Fortuz/mecanumbot/README.md

# Mecanumbot Project - Onboard Jetson codes

Mecanumbot is a mecanum-wheel member of the TurtleBot3 family, and the experimental robot platform for HRI and attention-guidance research.
This repository holds the ROS 2 Humble packages that run **on the robot itself**, on an NVIDIA Jetson Orin Nano (Ubuntu 22.04): the OpenCR hardware interface, launch orchestration, robot description and assets, joystick control, the web GUI, LEDs, camera capture, audio, and the map analysis behind the Deep3R seeking system.

## Built on TurtleBot3

Mecanumbot started from the original TurtleBot3 packages, but it uses a mecanum-wheel drive instead of a differential drive, and it adds motors that speak different protocols. That meant changing the original architecture, so a large part of the codebase has been modified. The aim is to keep the same functionality as the original TurtleBot3 repositories.

The setup steps are mostly the same as TurtleBot3's, so the TurtleBot3 e-Manual is still the main reference for documentation and background. The steps that matter for Mecanumbot are written out below.

- 📘 [TurtleBot3 e-Manual](https://emanual.robotis.com/docs/en/platform/turtlebot3/overview/#overview)
- 🐢 [turtlebot3, humble branch](https://github.com/ROBOTIS-GIT/turtlebot3/tree/humble)
- ✉️ [turtlebot3_msgs, humble branch](https://github.com/ROBOTIS-GIT/turtlebot3_msgs/tree/humble)

## Project Repositories

- [mecanumbot](https://github.com/Fortuz/mecanumbot) **(this repository)**: ROS 2 packages that run on the NVIDIA Jetson Orin Nano on the robot
- [mecanumbot_msgs](https://github.com/Fortuz/mecanumbot_msgs): every custom `.msg`/`.srv`, a build dependency of most packages here
- [mecanumbot_sensorprocess_smart](https://github.com/hubaycsenge/mecanumbot_sensorprocess_smart): LiDAR and camera people detection and their fusion
- [mecanumbot_behaviours](https://github.com/hubaycsenge/mecanumbot_behaviours): the `py_trees_ros` behaviour trees
- [mecanumbot_remote](https://github.com/Fortuz/mecanumbot_remote): ROS 2 packages for an external computer connected to the robot (keyboard teleop, LED GUI, and the `mecanumbot_sim` simulator)
- [mecanumbot_server](https://github.com/hubaycsenge/mecanumbot_server): ROS 2 packages that talk to the off-board compute server (`mecanumbot_deep3r`)
- [mecanumbot_microcontrollers](https://github.com/Fortuz/mecanumbot_microcontrollers): the microcontroller code
- [mecanumbot_python](https://github.com/fegyobeno/mecanumbot_python.git): native Python scripts for driving the motors, kept on the robot in `~/Sandbox`

## Packages in this repository

There are twelve packages, including the `mecanumbot` metapackage. All of them belong to the onboard Jetson stack, and `mecanumbot_monitor` also works on a development machine.

- **`mecanumbot`**: Dependency aggregation only. No nodes, no launch files: installing it pulls in the runtime packages.
- **`mecanumbot_core`**: The only code that talks to the OpenCR board. `mecanumbot_io_node` owns the serial link (CRC8-CCITT framing) and the mecanum kinematics, turning `cmd_vel` into four wheel commands; `mecanumbot_sensorproc_node` turns board telemetry into `odom`, `imu`, `joint_states`, battery state, `has_object` and the `odom → base_footprint` transform, plus `orin_battery_state` from the INA219 when running on a Jetson; `mecanumbot_battery_alert` raises a visible low-battery alarm; `mecanumbot_scan_grid_node` republishes the LD08 scan on a fixed 200-sector grid as `/mecanumbot/scan_grid`, which is what slam_toolbox reads.
- **`mecanumbot_bringup`**: Launch orchestration. No node logic of its own — it starts nodes from the other packages and picks map / Nav2 params from the current Wi-Fi SSID. Holds `launch_mecanumbot_base.launch.py` (full onboard stack), `nav2.launch.py` (the study Nav2 stack, included by the base launch under `use_nav2` and restartable on its own), `launch_external.launch.py` (operator PC), and the camera, state-publisher, mapping, SLAM and RViz launches. Simulated runs are not started from here: `sim.launch.py` is in `mecanumbot_sim`, in `mecanumbot_remote`, and does not need this package.
- **`mecanumbot_description`**: Robot assets, no nodes: URDF/xacro and meshes, maps, Nav2/SLAM/Cartographer parameter sets (including the T1 exploration and T2 seek Nav2 sets), the Nav2 behaviour-tree XMLs, RViz layouts, the joystick profile YAMLs, the udev rules for `/dev/opencr`, `/dev/ld08_lidar` and `/dev/arduino_nano`, and the systemd autostart unit.
- **`mecanumbot_joy`**: The robot's joystick node and the only `/joy` consumer. Applies a YAML mapping profile (`mecanumbot_description/config/joystick/`) to publish `/cmd_vel`, `/cmd_accessory_pos` and LED service calls. Layout decoding, profile validation and the action vocabulary live in rclpy-free modules, so they are unit-tested without a ROS graph. Replaces the old operator-PC teleop and the retired `mecanumbot_gui` controller stack.
- **`mecanumbot_web`**: The robot-hosted web GUI (Flask inside an rclpy node) at `http://<robot>:8080`, started by the base launch and disabled with `use_web:=false`. Three pages: `/joystick` edits and reloads the joystick profile with a live `/joy` readout, `/diagnostics` shows Nav2 stack state (with a restart), LED state, commanded-vs-measured movement and measured publish rates against nominal, `/behaviour` picks one of the behaviour trees (leading, ostensive, seek, fetch, autoslam, demo), edits the constants it loads and starts/stops it. No login, no database.
- **`mecanumbot_led`**: `set_led_status` / `get_led_status` services, forwarded over serial to the Arduino Nano LED controller at `/dev/arduino_nano`.
- **No camera publisher.** `mecanumbot_camera_stream` -- raw, JPEG and H.264 publishers for the webcam -- was removed on 2026-10-09. Nothing included it any more: the base launch had stopped, `perception.launch.py` had stopped, and the two things that want frames each open `/dev/video0` themselves (`mecanumbot_deep3r` with `camera_source:=direct`, `mecanumbot_sensorprocess_smart`'s detectors likewise). A device opens once, so a publisher nobody read was a publisher that could only take the camera away from whoever did. What a topic-based consumer needs instead is below.
- **`mecanumbot_cam_optim`**: A C++ capture path, built on `rclcpp`, `cv_bridge` and `image_transport`: `camera_stream_node` publishes JPEG on `/camera/image_raw/compressed` from `device` (default `/dev/video0`), trying a `libcamerasrc` pipeline first and warning before it falls back to V4L2 -- the normal path on this robot, which has no CSI camera. It has no launch file, so `ros2 run`. **This is now the only image publisher in the workspace**, and the only way to feed anything set to `camera_source:=topic`. No README; package manifest is still a TODO stub.
- **`mecanumbot_audio`**: Publishes microphone blocks as `mecanumbot_msgs/AudioData`, with device auto-detection and reopen-on-failure. No README.
- **`mecanumbot_custom_nav2`**: Map analysis for the Deep3R seeking system, and no motion. Libraries: an RRT frontier detector over slam_toolbox's occupancy grid, the occupancy model, the frontier scoring, and the T1 exit criteria (which include the server's reconstruction verdict). The pass that drives on the strength of them is `mecanumbot_autoslam`, in `mecanumbot_behaviours`; sending the robot to a frontier is a behaviour, so it lives there with the launch files that start it. It replaces no part of Nav2: the exploration tuning is a parameter file in `mecanumbot_description`. `mecanumbot_map_agreement_node` runs in **both** phases and is the robot's end of the 2D/3D comparison: it turns the server's verdict into a Nav2 keepout mask (the lidar is one horizontal plane, so a table top or a low step is "free" in the 2D map and lethal in the cloud), a revisit list and RViz markers. It only ever *adds* obstacles.
- **`mecanumbot_monitor`**: Test and evaluation utilities: `wheel_monitor` and `accessory_monitor` generate repeatable command patterns for drivetrain and servo testing; `rosbag_stepper` chunks bag playback; `metric_eval` logs ground truth against detections to CSV.

Every package except `mecanumbot`, `mecanumbot_audio` and `mecanumbot_cam_optim`
has its own README with the full publisher / subscriber / parameter tables — read
the relevant one before changing a node interface.

## Hardware

The full component list — every board, motor, sensor and 3D-printed part, with where to buy it and a price — is in [docs/COMPONENTS.md](docs/COMPONENTS.md).

## Onboard computer

The whole onboard stack runs on an **NVIDIA Jetson Orin Nano** (JetPack 6, Ubuntu 22.04, ROS2 Humble). Earlier revisions of the robot used a Raspberry Pi; the packages in this repository are now developed and tested on the Orin Nano.

What the platform change means in practice:

| Area | On the Jetson Orin Nano |
| --- | --- |
| OS / ROS | JetPack 6 (Ubuntu 22.04) + ROS2 Humble, `aarch64`. |
| Camera | A USB (UVC) webcam on `/dev/video0`, opened with V4L2 by whichever node needs it -- there is no camera publisher and no CSI camera. The mode is a *request*: `cap.set` on a webcam that cannot do 1280x720 picks something else and reports success, so the node that opened it reads the mode back and logs what it got. |
| H.264 encoding | Nothing encodes H.264 any more; it went with `mecanumbot_camera_stream`. Frames are JPEG, encoded once by the node that read them. |
| Onboard power rail  | `mecanumbot_sensorproc_node` reads an INA219 over I2C and publishes `orin_battery_state`. This publisher only exists when the device tree reports a Jetson. |
| GPIO | The `wiringpi` debug toggle from the Pi build is disabled; `wiringpi` is not installed and is not a dependency. |
| Serial devices | OpenCR, LD08 lidar and the LED Arduino Nano are still USB serial and are addressed through the udev rules in `mecanumbot_description/udev/`. |

Nodes detect the board at runtime by reading `/proc/device-tree/model`, so the same source tree still starts up on a non-Jetson machine — the Jetson-only publishers are simply skipped.

### Jetson specific setup

```
$ sudo usermod -aG dialout,i2c $USER   # serial + INA219 access, re-login afterwards
$ sudo nvpmodel -q                     # list available power modes
$ sudo nvpmodel -m 0                   # highest power mode (mode numbers differ per Orin Nano variant)
$ sudo jetson_clocks                   # lock clocks to max for consistent latency
$ pip install adafruit-blinka adafruit-circuitpython-ina219
```

`adafruit-blinka` provides the `board` and `busio` modules that `mecanumbot_sensorproc_node` imports on the Jetson.

Check that the board is what the nodes expect:

```
$ cat /proc/device-tree/model     # -> NVIDIA Jetson Orin Nano ...
$ sudo i2cdetect -y -r 7          # INA219 should show up (bus number can differ)
```

<p align="center">
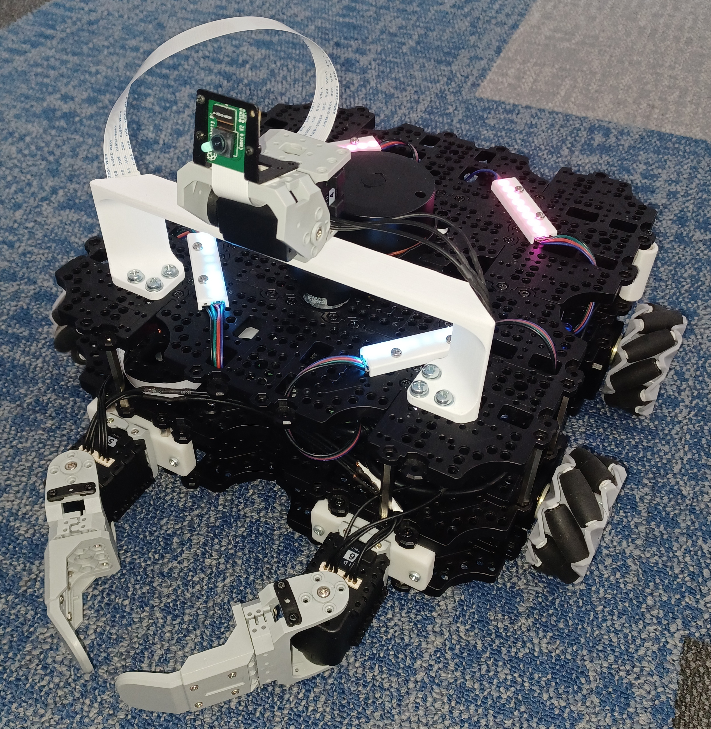
[picture p1: docs/images/mecanumbot.jpg]
Mecanumbot
  
</p>

<p align="center">
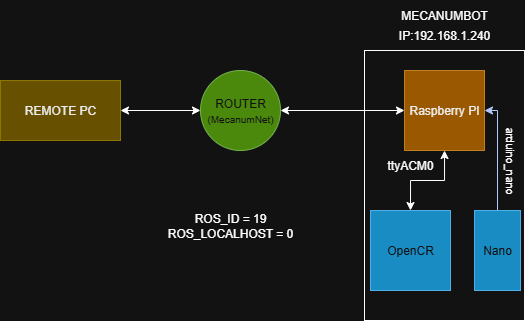
[picture p2: docs/images/turtlebot_architecture.drawio.png]
Architecture
  
</p>

## Install

Run this on the Jetson Orin Nano (the `ubuntu` user and the `192.168.1.240` address below are the ones flashed on the current robot — adjust if yours differ).

```
$ ssh ubuntu@192.168.1.240
$ mkdir -p ~/mecanumbot_ws/src && cd ~/mecanumbot_ws/src
$ git clone https://github.com/Fortuz/mecanumbot.git
$ cd ~/mecanumbot_ws/
$ echo 'source /opt/ros/humble/setup.bash' >> ~/.bashrc
$ source ~/.bashrc
$ colcon build --symlink-install --parallel-workers 2
$ echo 'source ~/mecanumbot_ws/install/setup.bash' >> ~/.bashrc
$ source ~/.bashrc
$ echo 'export OPENCR_PORT=/dev/ttyACM0' >> ~/.bashrc
$ echo 'export OPENCR_MODEL=mecanumbot' >> ~/.bashrc
$ echo 'export ROS_DOMAIN_ID=19' >> ~/.bashrc
$ echo 'export LDS_MODEL=LDS-02' >> ~/.bashrc
$ echo 'export TURTLEBOT3_MODEL=mecanumbot' >> ~/.bashrc
$ echo 'export ROS_LOCALHOST_ONLY=0' >> ~/.bashrc
$ echo "export RMW_IMPLEMENTATION=rmw_cyclonedds_cpp " >> ~/.bashrc
$ echo "alias start_robot='ros2 launch mecanumbot_bringup launch_mecanumbot_base.launch.py'" >> ~/.bashrc
$ source ~/.bashrc

```

The Orin Nano has enough RAM to build with more than one worker, but a full workspace build can still exhaust memory. If `colcon` gets OOM-killed, drop back to `--parallel-workers 1` or add swap.

Also install the udev rules so `/dev/opencr`, `/dev/ld08_lidar` and `/dev/arduino_nano` exist:

```
$ sudo cp ~/mecanumbot_ws/src/mecanumbot/mecanumbot_description/udev/*.rules /etc/udev/rules.d/
$ sudo udevadm control --reload-rules && sudo udevadm trigger
```

### Autostart on boot

The startup script and the systemd unit are kept in the repository under `mecanumbot_description/services/`, so they do not have to be written by hand:

```bash
$ chmod +x ~/mecanumbot_ws/src/mecanumbot/mecanumbot_description/services/autostart.sh
$ sudo cp ~/mecanumbot_ws/src/mecanumbot/mecanumbot_description/services/ros2.service /etc/systemd/system/ros2.service
```

Both files reference the `ubuntu` user and `/home/ubuntu/mecanumbot_ws`. If the Jetson was flashed with a different username, edit the `User=` line in `ros2.service` and the source paths in `autostart.sh` before installing.

Reload systemd and enable the service:

```bash
$ sudo systemctl daemon-reload
$ sudo systemctl enable ros2.service
```

Check the service logs:

```bash
$ journalctl -u ros2.service -f
```

## Bringup

```
$ ssh ubuntu@192.168.1.240
$ start_robot
```

The base launch already starts `mecanumbot_led_service`; starting a second one by hand would open `/dev/arduino_nano` twice.

## Connect new PC to robot

[Remote PC]

Install Ubuntu 22.04 OP system [Ubuntu 22.04](https://emanual.robotis.com/docs/en/platform/turtlebot3/overview/)

Install ROS2 Humble [ROS2 Humble install tutorial](https://emanual.robotis.com/docs/en/platform/turtlebot3/overview/)

Set static IP for computer on MecanumNet (192.168.1.XXX, XXX between 2 and 255)

<p align="center">
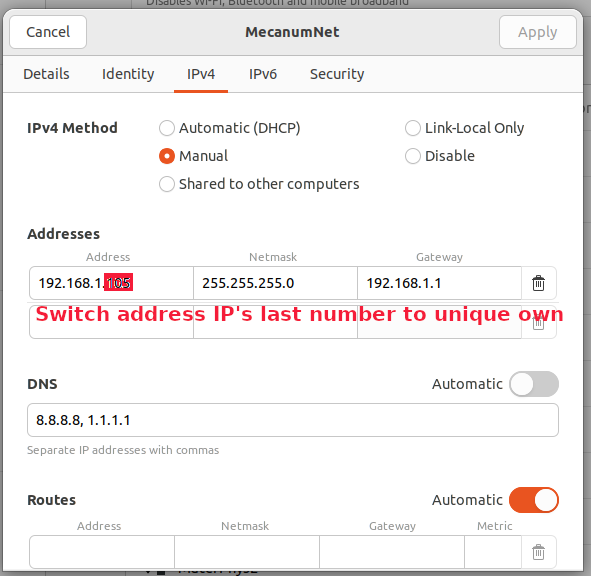
[picture p3: docs/images/MecanumNet_settings.png]
  
</p>

```
$ sudo apt update
$ sudo apt install ros-humble-navigation2 ros-humble-nav2-bringup ros-humble-tf-transformations ros-humble-py-trees ros-humble-py-trees-ros ros-humble--rmw-cyclonedds-cpp
$ pip install torch
$ mkdir mecanumbot_directories #makes stuff prettier to have all in one space
$ cd mecanumbot_directories
$ git clone https://github.com/VisualComputingInstitute/DR-SPAAM-Detector.git  # leg detector nn
$ cd DR-SPAAM-DEetector/dr_spaam
$ python setup.py install
$ cd ../../
$ mkdir mecanumbot_ws &c cd mecanumbot_ws
$ mkdir src && cd src
$ git clone https://github.com/Fortuz/mecanumbot
$ git clone https://github.com/Fortuz/mecanumbot_remote
$ git clone https://github.com/Fortuz/mecanumbot_msgs
$ git clone https://github.com/hubaycsenge/mecanumbot_behaviours
$ git clone https://github.com/hubaycsenge/mecanumbot_sensorprocess_smart
$ cd ..
$ colcon build --symlink-install
$ echo 'export RMW_IMPLEMENTATION=rmw_cyclonedds_cpp' >> ~/.bashrc
$ echo '~/mecanumbot_directories/mecanumbot_ws/install/setup.bash' >> ~/.bashrc
$ echo 'export ROS_DOMAIN_ID=19' >> ~/.bashrc
$ source ~/.bashrc
```

[ Mecanumbot ]

```
$ sudo nano /etc/chrony/chrony.conf
$ server 192.168.1.XXX minpoll 0 maxpoll 2 iburst #XXX is your PC's unique IP
$ sudo systemctl restart chrony
```

## TESTS

### LED control

Send a message to get back the actual status of the leds

```
$ ros2 service call /mecanumbot/get_led_status mecanumbot_msgs/srv/GetLedStatus "{}"
```

Send a message to set the status of the leds

```
$ ros2 service call /mecanumbot/set_led_status mecanumbot_msgs/srv/SetLedStatus "{
  fl_mode: 1,
  fl_color: 3,
  fr_mode: 1,
  fr_color: 3,
  br_mode: 1,
  br_color: 3,
  bl_mode: 1,
  bl_color: 4
}"
```

PC

```
$ echo "export RMW_IMPLEMENTATION=rmw_cyclonedds_cpp " >> ~/.bashrc
$ cd ~/dev_ws
$ source_ros
$ source_ws
$ ros2 run mecanumbot_teleop mecanumbot_keyboard
$ ros2 launch mecanumbot_ledgui mecanumbot_ledgui.launch.py
```

Parameters: `<br>`
wheel diameter: 65 mm `<br>`
wheel radius: 32.5 mm `<br>`
wheel thickness: 30 mm `<br>`
wheel separation x: 129 mm `<br>`
wheel separation y: 300 mm `<br>`
