Fortuz/mecanumbot/mecanumbot_web/README.md

# mecanumbot_web

The robot-hosted web GUI. A normal rclpy node that also serves Flask, reachable
at `http://<robot>:8080` once the onboard stack is up.

**Off the lab WiFi, use `robot web`.** The node binds `0.0.0.0:8080` and starts
with the base launch — `use_web` defaults true, and nothing in the Deep3R / T1
path turns it off — but the robot↔cluster link in
`mecanumbot_directories/RoboCamStreamProcessing/link/` forwards only two ports,
22 and 5555. nipg1 has no route to the robot's LAN, so from there the page does
not answer, which looks exactly like the node having failed to start. `robot
web` forwards it over the control tunnel that already exists and prints the URL;
`MECANUMBOT_SSH_HOST=mecanumbot-jump robot web` does the same from a laptop.
Deliberately on demand and bound to your own loopback: this GUI has no login and
can drive the robot. See that directory's README.

It replaces a Flask app that ran in a Docker container **on the operator PC**,
paired with two ROS packages on the robot, sharing a SQLite schema that existed
in two copies — one per machine. That arrangement is what produced the "host
settings vs robot settings" split throughout the old UI: a
`destination: host | robot | both` parameter on six API routes, a
`from_robot_db` flag on `ApplyMapping`, and two side-by-side host/robot mapping
panels. None of it described anything about the robot; it only arbitrated
between two files. With the GUI on the robot there is one copy — the YAML in
the packages that own it — so the distinction has nothing left to describe.

There is no login and no database.

## Pages

| Path | Function |
| --- | --- |
| `/joystick` | Edit and reload `mecanumbot_joy`'s profile, with a live input readout. |
| `/diagnostics` | Whether the navigation stack is up, with a restart; what the LEDs are showing, how the robot is moving, and the measured publish rate of every important topic against nominal. |
| `/teleop` | Drive the robot, move the neck and grabbers, and set the LEDs. |
| `/behaviour` | Choose a behaviour tree, edit the constants it will load, and run it. |
| `/maps` | Choose the map folder nav2 loads, and load it. |

`/` redirects to `/diagnostics`.

### Alert lines

Every page polls `/api/alerts` every 2 s and shows each hardware fault as one thin
line under the tabs, which stays in view when the page is scrolled. The faults come
from `mecanumbot_core`'s `mecanumbot_battery_alert`, on `hardware_alerts`, so the page
and the node cannot disagree about thresholds or timing, and nothing here has to
deserialise the 100 Hz `opencr_state`.

| Line | Means |
| --- | --- |
| Yellow | Motors not responding: the OpenCR cannot read the Dynamixel bus. |
| Red | OpenCR not responding, or a battery is low (the LEDs blink red for that too). |
| Grey | Faults unknown: the monitoring node is not reporting, or the page lost the robot. |

The grey line exists because no line at all has to mean a healthy robot.

### Joystick

Bindings are rendered as the ten fixed vocabulary rows, each with a dropdown
populated from the controls *that profile declares* — so a binding naming a
control the pad does not have cannot be expressed, rather than merely being
rejected on save. Validation is `mecanumbot_joy.profile.validate_document`, the
same function the node runs, so the GUI cannot save something the robot would
refuse to load.

The live readout polls `/joy` at 5 Hz and shows which axis or button index
moved. That is the fastest way to build a profile for a pad nobody has mapped
before, and it is what the old GUI's static controller PNG never provided.

### Diagnostics

Answers "is each node keeping up?". Nothing in the workspace measured this
before — the old GUI had presence/absence watchdogs that could tell you a topic
had gone silent, but not that it had quietly dropped from 100 Hz to 12 Hz.

Subscriptions are created with `raw=True`, so payloads are never deserialised
and monitoring a 100 Hz `OpenCRState` costs almost nothing on the Orin. Rates
come from a sliding window over *receipt* times: several monitored topics carry
no header at all, and the question being asked is whether the pipeline is
delivering to a subscriber.

| Status | Meaning |
| --- | --- |
| `OK` | Within tolerance of nominal. |
| `SLOW` | Running but below tolerance — usually CPU contention or a blocked callback. |
| `FAST` | Above tolerance. Informational; usually means the nominal figure is stale. |
| `IDLE` | Silent, but silence is this topic's resting state and it is still wired up. |
| `DEAD` | Nothing on the graph holds the topic up, or nothing received recently enough to measure. |

The nominal table is `config/diagnostics_topics.yaml`; every rate in it is read
from the node that publishes it, with the source noted per entry. Topics with
`nominal_hz: 0` are event-driven and judged on staleness alone, so an idle
`/cmd_vel` never reads SLOW.

#### Navigation stack

The first panel answers "is nav2 up, and if not, bring it back". The state is
one word: `ACTIVE`, `INACTIVE` (every server registered, but a lifecycle
manager reports them inactive — the shape of a bringup that aborted, which
presence alone reads as healthy), `NO ANSWER`, `PARTIAL`, `DOWN`, or `T1` when
an exploration pass is running its own nav2. Presence comes from the graph and
activity from each manager's `is_active` service, asked from the page's own
poll every 3 s with a 1 s timeout.

**Restart is a relaunch, not a lifecycle reset.** A T1 pass's preflight
signals the composed `nav2_container` away rather than deactivating it, so
after T1 there is nothing left for `manage_nodes` RESET to reset. A restart
(`nav_stack.py`) therefore:

1. stops the stack wherever it came from — the one this page launched
   last time via its process group, and any other local process whose command
   line carries `__node:=<a study nav2 node>` (the base launch's container, the
   keepout servers), by pid with SIGINT, then SIGTERM, then SIGKILL. Matched on
   that whole argument only, so the base `ros2 launch` whose arguments merely
   name nav2 is never touched, and **not** excluding this node's process group:
   the base launch started this node and nav2 together, so they share one;
2. waits for every study nav2 name to leave the **graph**. A new
   `lifecycle_manager_navigation` configures servers by name, and an old one
   still answering aborts the new bringup. A stack on another machine
   (`launch_external` can start one) has no local process to signal, stays on
   the graph, and the restart fails naming it rather than launching over it;
3. runs `ros2 launch mecanumbot_bringup nav2.launch.py` as a child, whose
   console the panel shows. The launch file re-reads the SSID, so a restart
   after moving rooms loads the other room's map, unless the maps page has
   pinned one.

**Refused while** a tree runs from the behaviour page, a tree is on the graph
from a terminal, or a T1 pass is up (its nav2 uses the same node names, so a
restart would kill it). Restarting under a tree drops its goals mid-trial.
AMCL comes back at its initial pose, so the pose estimate has to be set again;
the confirmation dialog says so.

A stack relaunched from here is a child in its own session, so a Ctrl-C of the
base launch does not reach it; `web_node`'s shutdown stops it, after any tree.
A stack the base launch started is that launch's, and is left alone at shutdown.
`mecanumbot_bringup` is not declared as a dependency, because bringup depends
on this package; the launch file is only found at runtime.

On a machine with no robot attached the costmaps wait for TF indefinitely
during activation and ignore SIGINT and SIGTERM while they do, so there a
restart always escalates to SIGKILL. Expected; on the robot they exit on
SIGINT.

#### Idle is not dead

Several topics are *supposed* to be silent most of the time, and grading those
red would train the operator to ignore the colour that means something is
broken. `idle_when_silent: true` in the table marks them, and `presence` says
which end of the topic proves it is still wired up:

| Topic | Silent because | Alive because |
| --- | --- | --- |
| `/cmd_vel`, `/cmd_accessory_pos` | nothing is driving the robot | the io_node is still **subscribed** — nothing publishes these at rest, so the listener is the only evidence the link is intact |
| `people_fusion`, `subject_pose` | nobody is in view (`mecanumbot_locate_detections` only publishes a non-empty array; `subject_pose` publishes nothing until a subject is first seen) | the detector is **publishing** it at all |

So `DEAD` on `/cmd_vel` means a command would go nowhere, and `DEAD` on
`people_fusion` means the detector is down — both real faults, neither of them
"the robot is standing still" or "the room is empty". The table shows both
endpoint counts, dimming whichever one is not deciding.

Three traps the implementation handles: monitor subscriptions are BEST_EFFORT
(`scan` and the compressed camera topics are published that way, and a RELIABLE
subscription silently never matches one, so a healthy topic would read DEAD);
discovery re-runs on a timer, because this node starts alongside everything it
monitors and a one-shot lookup would miss all of it; and the subscriber count
discounts this node's own monitoring subscription — it subscribes to everything
in the table, so a raw `count_subscribers` would never be zero and a
subscriber-judged topic could never read DEAD.

#### Robot state: LEDs and movement

Rates answer "is every node keeping up?", which is not the same question as
"what is the robot doing". Two panels above the topic table answer the second
one, from the same 1 Hz poll — `/api/diagnostics` carries `led` and `motion`
alongside `topics`, so the page makes no extra requests.

**LEDs.** Four corner swatches in physical layout, each showing the colour and
the mode, and *animating the way the strip does* — pulse breathes, the two
blink modes blink at their own speeds, the wave modes sweep. There is no LED
state topic anywhere in the workspace; the Arduino Nano is only ever asked, so
this comes from the `get_led_status` service, which is a serial round trip on
the same link the behaviour trees use to set the LEDs. It is therefore polled
on a slow timer (`led_poll_period`, 2 s) into a cache the page reads, and can
lag a change by a second or two.

Three details are deliberate. The poll is `call_async` with a done callback,
not a blocking wait — it runs on an executor timer, and blocking there would
stall a callback group the rest of the node shares. A poll still outstanding
suppresses the next one, so a silent Arduino cannot queue requests behind
itself. And the all `-1` response the LED node returns for a bad checksum or a
silent board is treated as a failed read: it is reported as an error and the
last good reading stays on screen, rather than being rendered as a state the
strips can be in.

**Movement.** Commanded velocity from `/cmd_vel` beside measured velocity from
odometry, each classified into words. Showing both is the point: a command with
no measurement under it is a drivetrain fault, and it is invisible to
everything else on this page because both topics stay perfectly healthy
throughout. The panel calls that case out in words.

Classification lives in `motion.py`, with no rclpy in it. Mecanum drive is why
it is not a one-liner — `vy` is a real degree of freedom rather than
structurally zero, so "forward" and "strafing left" hold simultaneously during
a diagonal and the state is built from up to three components. Deadbands
(0.02 m/s, 0.05 rad/s) are set by what odometry noise looks like on a
stationary robot, so a parked robot does not read as creeping. The dial shows
direction of travel with the robot facing up, and a pure spin leaves it
unpointed because a spin has no direction of travel.

Odometry runs at 50 Hz and the page reads once a second, so that subscription
is `raw=True` like the monitor's and the bytes are deserialised at most every
0.2 s — the same reasoning as the rate monitor, taken one step further because
here the payload is actually wanted. Set `odom_topic` to an empty string to
drop the subscription entirely; the panel then says it is showing commanded
velocity only.

### Teleop

Three controls, each going to the interface the joystick node already uses:

| Control | Goes to | How |
| --- | --- | --- |
| Three signed scales (`vx`, `vy`, `wz`), *Hold to drive* button or held `Space` | `cmd_vel_topic` (`/cmd_vel`), `Twist` | streamed under a dead-man lease while held |
| Neck, left and right grabber sliders; Open / Front / Close | `accessory_topic` (`/cmd_accessory_pos`), `AccessMotorCmd` | one message per change |
| A colour and a mode per corner, *Apply* | `led_set_service` (`set_led_status`), `SetLedStatus` | one blocking call per *Apply* |

**The scales set the command; the hold button sends it.** Each scale runs
from minus to plus its limit with zero in the middle (double-click one to zero
it, *Zero all* for all three), and a number box beside it takes an exact value.
Nothing moves until *Hold to drive* (or `Space`) is held, and the scales can be
moved while it is.

**Velocity is a lease** (`teleop.py`). While a control is held the page re-sends
the command every 100 ms. Each send renews a 0.4 s lease, and the node publishes
the leased command at 20 Hz. When the lease runs out, or the page sends a stop,
the node publishes 5 zero frames and then goes **silent**. It goes silent rather
than holding zero because Nav2, the joy node and the behaviour trees publish
`/cmd_vel` too, and an open browser tab must not hold the robot still against them.
Letting go, switching tab, closing the page (a `sendBeacon` stop) and losing
Wi-Fi all end up at the same stop. The commands bypass Nav2 and its costmap.

**The limits are `mecanumbot_joy`'s**, imported from `mecanumbot_joy.profile`
(`DEFAULT_LIMITS`, `DEFAULT_NECK`, `DEFAULT_GRIPPER`). The page clamps per axis
to `max_lin_vel` / `max_ang_vel` (the scales' ends), and clamps the
accessories to the neck and gripper ranges. Open / Close are the joystick's
`gripper_open` / `gripper_close` positions. The mirror checkbox moves the two
grabbers in equal and opposite steps about `front`. The sliders start at the
profile defaults, not at the servos' real positions, so nothing is sent until
one of them moves. After that, all three positions go out together.

**LED changes are staged until *Apply*.** Each corner has its own colour and
mode; *Fill* copies one pair into all four. Corners that differ from what was
last applied are outlined, and *Revert* undoes them. The staged corners start
from the last `get_led_status` reading, so a corner you did not change is sent
as it already is: the service always carries all four corners. Under each
corner is the controller's own reading. `progress` is sent as 0.
A successful set triggers an immediate re-poll, so the diagnostics panel
catches up straight away.

**Other control surfaces are not locked out.** The page warns when a behaviour
tree is running, whether this GUI started it or a terminal did (it checks the
graph). It does not refuse to drive, because the operator may need to step in.
While a pad is connected, the joystick node re-sends its own accessory positions
at `accessory_keepalive_hz` (1 Hz), which takes the neck and grabbers back to
where the pad left them.

### Maps

Lists every folder under `mecanumbot_description`'s installed `maps/` and loads
the one you pick. A map is `maps/<name>/<name>.yaml` beside the image it names;
a folder that breaks that is listed with what is wrong and cannot be loaded. A
new folder appears after `colcon build --packages-select mecanumbot_description`.

**Loading is saving the choice and restarting nav2** with the restart above, so
it is refused in the same situations (a tree running, a T1 pass), and a refusal
puts the previous choice back. AMCL comes back at its initial pose, so the pose
estimate has to be set again. "Running on" is asked of the map server itself
(`yaml_filename`), so it stays true of a stack this page did not start.

**The choice is a pin over the Wi-Fi rule**, kept in
`~/.mecanumbot/selected_map.yaml`, so it survives a reboot and the base launch
honours it too. "Follow the Wi-Fi" removes it. With no pin `nav2.launch.py`
picks what it always did; a pinned folder that has since gone falls back to the
SSID's map and the launch log says so. `map_store.py` holds the rule and the
launch file imports it, so the page and the launch cannot disagree.

The keepout mask goes with the map: any folder with a `*_keepout.yaml` gets the
keepout servers and the keepout parameter file, whichever network the robot is
on. **The behaviour constants do not move.** They are still chosen by SSID and
their routes are coordinates on one map, so the page warns whenever the loaded
map is not the one the network's constants were written for.

### Behaviour

One page for a whole trial: pick the tree, set the hyperparameters, edit the
constants it will load, start it, watch its console, stop it.

| Behaviour | Started as | Hyperparameters |
| --- | --- | --- |
| Leading | `ros2 launch mecanumbot_leading_behaviour launch_wifi_condition_sequence.launch.py` | **condition** (`Doglike` / `Control` / `LED`), constants file, namespace |
| Ostensive | `ros2 launch mecanumbot_ostensive_behaviour launch_ostensive.launch.py` | constants file, namespace |
| Seek (T2) | `ros2 launch mecanumbot_seek launch_seek.launch.py` | constants file, namespace |
| Fetch | `ros2 launch mecanumbot_fetch_behaviour launch_fetch.launch.py` | constants file, namespace |
| Autoslam (T1) | `ros2 launch mecanumbot_autoslam launch_autoslam.launch.py` | **require_cloud**, **use_preflight**, **publish_debug_image**, **use_deep3r**, **server_port**, constants file, namespace |
| Demo: wander between people | `ros2 run mecanumbot_demo_behaviours wander_between_people_node` | constants file, namespace |

Seek, fetch and autoslam were startable from a terminal for months before they
were startable from here, which meant a trial run from the browser and one run
from a shell were not the same set of experiments. They are now.

**Autoslam is the one row that stops the others.** T1 replaces the navigation
stack rather than using it, so its launch file opens by shutting down the study
nav2 stack, AMCL, the map server and any behaviour tree it finds on the graph —
including one started from this page. That is the point of it, but it is worth
knowing before clicking Start, which is why the row carries the warning.
`use_preflight:=false` skips it, and then the two stacks fight.

It is also the one row that brings up hardware and a network link: the launch
file starts the Deep3R client, which opens the camera itself, because T1 cannot
finish without it. Set **use_deep3r** to `false` if one is already running: a
second client is a second run, for which the server wipes its reconstruction,
and `/dev/video0` opens once. **publish_debug_image** replaced the old "Start
the camera" switch -- there is no camera publisher any more; it republishes the
exact frames the client sent, for watching a run. The cluster server and the
tunnel still have to be up before Start. **server_port** is the local port the
client connects to (`tcp://127.0.0.1:<port>`, default `5555`); change it when
5555 is held by something else, and forward the same port in the tunnel.

The catalog is `behaviour_catalog.py`, and every entry is the command the
workspace documents for that tree — so a run started here and a run typed at a
terminal are the same run. The demo is the one exception to "use the launch
file", and for a stated reason: its launch file names `*_demo_bt_node`
executables its `setup.py` does not register, so launching it fails.

The constants file is not a separate control. The file the run will load *is*
the file the editor below is editing, chosen once, defaulting to whatever the
current SSID selects.

Only what a hyperparameter's own spec allows can be sent: a condition must be
one of the three the launch file implements, a namespace must be a single ROS
name token, and a constants file must be a name that exists in that behaviour's
own config directory — matched against the directory listing rather than
sanitised, so traversal, absolute paths and typos all fail identically.
`build_command` returns an argv list and nothing reaches a shell.

**One tree at a time.** Every tree publishes `/goal_pose` and `/cmd_vel`, so a
second one does not run alongside the first — they fight over the robot and the
trial is quietly invalid rather than obviously broken. Starting while something
runs is an error, and the page also watches the ROS graph for a tree somebody
started from a terminal, which its own bookkeeping cannot see.

Stopping sends SIGINT to the child's process group, because `ros2 launch` shuts
its nodes down properly on SIGINT and killing it outright would orphan the tree
— still on the graph, still driving. SIGTERM and then SIGKILL follow only if it
will not go. The child gets its own session, which is also why `web_node`'s
shutdown path stops it explicitly: nothing else would.

The console is a 400-line ring buffer, polled incrementally and numbered so a
gap is reported rather than silently closed. It is where a missing prerequisite
shows up, since a tree whose `setup()` cannot find nav2 exits before the page
next polls.

#### Editing the constants

**Edits take effect the next time a behaviour tree starts, not live.** Every
tree reads its file once, in its params behaviour's `setup()`. The page says so,
and warns before starting a run with unsaved edits on screen.

Two schemas, two editors, for a reason:

- **Leading and demo** (`behaviour_store.py`) — thresholds, the route, and the
  LED and gesture sequences, whose inline comments are *derived from the values*
  and are regenerated on save. Plus the **tunables**: the turn profile, timeouts
  and poses that used to be constructor defaults in the behaviour library. Those
  carry the reasoning for their numbers in prose, which cannot be regenerated,
  so it is read off the outgoing file and written back around the same keys.
- **Ostensive, seek, fetch and autoslam** (`flat_store.py`) — a flat block of scalars whose comments *are*
  the documentation. Nothing is rewritten there: only the value on each
  parameter's own line changes, then the result is reparsed and checked that
  exactly the intended keys moved. Parameters cannot be added or removed, since
  the tree reads a fixed set.

The emitter's `_self_check` refuses to write a document that has lost a key.
That is not defensive dressing: before the tunables were carried through, a save
from this page deleted about thirty of them, and a tree that lost one would fall
back to a packaged default mid-experiment without saying anything.

Validation follows what actually consumes each file:

- A `_times` list **shorter** than its `_seq` list is a hard error —
  `LEDBehaviourSequence` reads `delays[index - 1]` up to `len(patterns)`, so it
  would raise `IndexError` mid-tick, during an experiment.
- A `_times` list **longer** is a warning. `Eto_behaviour_setting_constants.yaml`
  is currently in that state (`LED_indicate_close_target_times`,
  `Dog_indicate_target_times`); `behaviour_setting_constants.yaml` no longer is. The page offers a one-click trim but does not apply it silently:
  seven delays against five patterns most likely means two patterns were lost,
  not that the delays are wrong, and that call belongs to the operator.

Entries are Python dict literals stored as YAML strings, and the emitter writes
them by hand rather than through a YAML dumper — turning one into a real YAML
mapping breaks `ast.literal_eval` and the tree throws at setup. `dump()`
self-checks by reparsing before returning.

**A number's type is part of that contract.** The tree assigns several of these
values straight into ROS message fields, which are strictly typed:
`parse_checkpoint` puts `X`/`Y`/`Z` into a `geometry_msgs/Point` (`float64`), so
`'Z':0` is `AssertionError: The 'z' field must be of type 'float'` at `setup()`,
and `parse_led` does the mirror image into `SetLedStatus`' `int8` fields, where
a float is the error. The browser cannot express the difference — JSON has one
number type and `JSON.stringify` drops the decimal point off every whole number
— so `behaviour_store` decides the type from the key rather than from the
request: coordinates, poses and delays are always written as floats, LED codes
and counts as whole numbers, and a tunable keeps whichever shape the file it
replaces gave it. A value that fits no type (an emptied field arriving as
`null`, a fractional LED mode) is refused by name instead of being rounded.
`_self_check` verifies the types of the emitted literals too, since every other
check reads `0` and `0.0` as the same document.

A file that already carries the wrong type says so when it is opened, and
**saving repairs it** — types are restored before validation, so a document
written by an older version of this editor is fixed by loading it and pressing
Save.

Inline comments on the LED and gesture entries are **regenerated from the
values** rather than preserved, which is an upgrade: several comments in the
shipped files contradict what they annotate (`'color':6` is labelled "white"
where 6 is pink, `'color':2` is labelled "yellow" where 2 is green). The
tunables' comments are carried over instead, because nothing can regenerate a
sentence about why a turn speed has to stay inside Nav2's `max_vel_theta`.

## Saving config safely

Under `--symlink-install`, a package's installed config files are symlinks back
into the source tree. Writing through them correctly edits the checkout — but
only if the path is `realpath()`-resolved first. The obvious atomic-write idiom
`os.replace(tmp, share_path)` replaces the *symlink itself* with a regular file
and silently decouples install from source, making every later edit appear to
vanish on rebuild. `yaml_io.atomic_write_text` resolves first; there is a
regression test asserting the symlink survives a save.

Every write is backed up first, to `~/.mecanumbot/config_backups/` — outside
the source tree, because every file this GUI edits sits in a git repository the
user commits from. Five backups are kept per file and are restorable from the
GUI.

## Design

Pure modules with no rclpy: `rate_monitor.py`, `motion.py`, `joystick_store.py`,
`behaviour_store.py`, `flat_store.py`, `behaviour_catalog.py`,
`behaviour_runner.py`, `nav_stack.py`, `yaml_io.py`, `led_enums.py`. Then `ros_bridge.py`
(the node), `app.py` (Flask routes) and `web_node.py` (the entry point).

`behaviour_runner.py` spawns processes but touches no ROS API, so the Flask app
owns it and the node's only involvement is stopping it on shutdown.
`nav_stack.py` supervises nav2 with a second instance of the same runner, and
reads the graph through a function the app hands it.

The palette is cyan and magenta, defined once as custom properties in
`base.html` and themed for both `prefers-color-scheme` settings. It carries the
chrome only — nav, focus rings, bars, panel headings. The four rate statuses
stay green / amber / rose, with only their temperature pulled toward the theme:
an operator reads those at a glance and hue is the whole signal.

The executor owns the main thread and Flask runs in a daemon thread — the
opposite of the GUI this replaces, which suited a container whose only job was
to serve HTTP but made a poor ROS node, because SIGINT never reached the
executor and `ros2 launch` could not shut it down cleanly.

Service calls arrive on Flask threads, so the clients sit in a
`ReentrantCallbackGroup` under a `MultiThreadedExecutor` and block on an event
rather than spinning; under the default callback group the future would never
complete.

## Parameters

| Parameter | Default |
| --- | --- |
| `host` / `port` | `0.0.0.0` / `8080` |
| `joystick_config_dir` | `mecanumbot_description/config/joystick` |
| `behaviour_config_dir` | `mecanumbot_leading_behaviour/config` |
| `ostensive_config_dir` | `mecanumbot_ostensive_behaviour/config` |
| `demo_config_dir` | `mecanumbot_demo_behaviours/config` |
| `seek_config_dir` | `mecanumbot_seek/config` |
| `fetch_config_dir` | `mecanumbot_fetch_behaviour/config` |
| `autoslam_config_dir` | `mecanumbot_autoslam/config` |
| `diagnostics_config` | `mecanumbot_web/config/diagnostics_topics.yaml` |
| `joy_node` / `joy_topic` | `/mecanumbot/mecanumbot_joy_node` / `/mecanumbot/joy` |
| `backup_root` | `~/.mecanumbot/config_backups` |
| `led_service` | `get_led_status` |
| `led_poll_period` | `2.0` s — `0` disables LED reads |
| `cmd_vel_topic` | `/cmd_vel` — also where teleop publishes; empty disables both |
| `accessory_topic` | `/cmd_accessory_pos` — teleop neck/grabbers; empty disables |
| `led_set_service` | `set_led_status` — teleop LEDs |
| `odom_topic` | `odom` — empty disables measured motion |

Every behaviour config directory is resolved leniently: a behaviour whose package
is not in the checkout is shown on the page as unavailable, and cannot be edited
or started, rather than the GUI failing to come up.

`led_service` and `odom_topic` are **relative** names, so they resolve inside
this node's namespace alongside the LED service node and
`mecanumbot_sensorproc_node`. `cmd_vel_topic` is absolute because the base
launch remaps `cmd_vel` out of the namespace so Nav2 and the joy node meet on
one topic. `web.launch.py` declares `namespace` (`mecanumbot`), `web_host`,
`web_port`, `joystick_config_dir`, `behaviour_config_dir`, `diagnostics_config`,
`led_poll_period` and `odom_topic`; the other config directories, `backup_root`
and the joy/LED/`cmd_vel`/accessory names are only node parameters.

## Dependencies

**Flask is not installed by `rosdep`.** On the robot:

```bash
sudo apt install python3-flask
```

Jammy ships Flask 2.0.1, so avoid APIs added in 2.2 or later.

## Running

```bash
# with the rest of the onboard stack (use_web:=false to disable)
ros2 launch mecanumbot_bringup launch_mecanumbot_base.launch.py

# alone
ros2 launch mecanumbot_web web.launch.py web_port:=8080
```

## Tests

```bash
colcon test --packages-select mecanumbot_web && colcon test-result --verbose

# or directly, from the package directory
PYTHONPATH=.:$PYTHONPATH python3 -m pytest test/ -q -p no:launch_testing
```

About 275 tests, none needing a ROS graph; the route tests skip cleanly when
Flask is absent. Note that `pytest.importorskip` is deliberately **not** used for
that — raising `Skipped` at module level aborts collection for the whole
session under the pytest version Humble ships, which would silently reduce the
suite to one test instead of skipping one file.

`test_behaviour_runner.py` starts **real child processes** — short Python
scripts, not `ros2 launch`, injected by standing a fake spec in for the
catalog's. What that module is for is starting a process and being sure it is
gone afterwards, and a mocked `Popen` would prove neither. One of them ignores
SIGINT and SIGTERM, so the escalation to SIGKILL is exercised rather than
assumed.

`test_nav_stack.py` does the same for the navigation restart: stand-in
servers are child processes carrying `__node:=amcl` and the like, and the
graph is scripted from whether they are alive. The restarter is handed **only
those children** as its process list — it signals whatever matches, and a test
run beside a real nav2 must not stop it.
