Fortuz/mecanumbot/(list of files, cad)

Other CAD files:
mecanumbot_description/meshes/head.stl
mecanumbot_description/meshes/arm.stl
mecanumbot_description/meshes/arm_left.stl
mecanumbot_description/meshes/base.stl
mecanumbot_description/meshes/arm_right.stl
mecanumbot_description/meshes/wheel.stl
