Fortuz/mecanumbot/mecanumbot_bringup/README.md

# mecanumbot_bringup

Launch orchestration package for booting the robot stack.

This package does not contain ROS nodes implemented in source code. It provides launch files that start/configure nodes from other packages.

The onboard launch files run on the robot's NVIDIA Jetson Orin Nano. `launch_mecanumbot_base.launch.py` starts the onboard stack — drivers, Nav2, the joystick and the web GUI — on the Jetson itself; the remote PC is only needed for visualization and teleoperation.

**It no longer starts perception.** It used to, so every run of the robot — a teleop session, a mapping run, T1 exploration — carried a DR-SPAAM detector, a DeepStream network and the fusion node whether or not anything subscribed to them. On an Orin Nano that is not free: the network is most of the GPU, and it holds the camera open so nothing else can have it, which is why there was no `/camera/image_raw/compressed` to record a trial from. Perception is now started by the behaviour that needs it, from `mecanumbot_sensorprocess_smart/launch/perception.launch.py`, with the detector that behaviour needs. See that package's README.

## Launch file functions

| File | Function |
| --- | --- |
| `launch/launch_mecanumbot_base.launch.py` | Full onboard runtime. Starts `mecanumbot_io_node`, `mecanumbot_battery_alert`, `mecanumbot_sensorproc_node`, `ld08_driver`, `mecanumbot_led_service`, the audio input handler, the robot state publisher include, and — under `use_nav2` — `nav2.launch.py`. **No perception** — that is started by the behaviour that needs it. |
| `launch/nav2.launch.py` | The study navigation stack on its own: the `nav2_bringup` include with AMCL and the saved map, plus the keepout mask servers when the map has a mask. Map, Nav2 parameter set and keepout mask are selected from the web GUI's maps page if a map is pinned there, otherwise from the Wi-Fi SSID, **when this file is launched**, and `NAV2_PARAMS_FILE` overrides the parameter file. Split out of the base launch so the web GUI can restart nav2 without the drivers — see `mecanumbot_web/README.md`, "Navigation stack". |
| `launch/launch_external.launch.py` | Operator-PC tools: RViz (`use_rviz`, default true). It starts **no perception** unless asked (`use_people_detection:=true`, for running DR-SPAAM off the robot) — the behaviour that needs people detection starts it itself, and a second `mecanumbot_lidar_detect_people` on the domain publishes over the robot's. Nav2 and the SSID map selection are commented out at the bottom of the file. |
| `launch/mapping.launch.py` | Starts `slam_toolbox` (`async_slam_toolbox_node`) with `mecanumbot_description/param/mecanumbot_slam_mapping.yaml`, plus `mecanumbot_core`'s `mecanumbot_scan_grid_node`: slam_toolbox reads `/mecanumbot/scan_grid`, the LD08 scan on a fixed angular grid, not the driver's own scan (see `mecanumbot_core/README.md`). |
| `launch/slam_gmapping.launch.py` | Starts `cartographer_node` and `cartographer_occupancy_grid_node` using `mecanumbot_description/param/mecanumbot_lds.lua`. |
| `launch/mecanumbot_state_publisher.launch.py` | Starts `robot_state_publisher` with robot description from URDF/xacro. |
| `launch/rviz2.launch.py` | Starts RViz with the package-provided visualization config. |
| ~~`launch/camera.launch.py`~~ | **Deleted 2026-10-09**, with the `mecanumbot_camera_stream` package it included. By then nothing included *it*: the base launch had stopped, `perception.launch.py` had stopped, and T1 was the last caller. There is no camera publisher now and nothing needs one -- `mecanumbot_deep3r` and the perception detectors each open `/dev/video0` themselves (`camera_source:=direct`). `use_camera` is retired: `launch_autoslam` still accepts it, logs that it did nothing, and carries on. For a topic-based consumer, `mecanumbot_cam_optim`'s `camera_stream_node` is the surviving publisher. |
| ~~`launch/sim.launch.py`~~ | **Moved 2026-10-09** to `mecanumbot_sim` in the `mecanumbot_remote` repo, and reads nothing from this package, so the simulator starts without the robot's launch package. See `mecanumbot_sim/README.md`. |

## Base launch arguments

| Argument | Default | Function |
| --- | --- | --- |
| `namespace` | `mecanumbot` | Robot namespace. |
| `use_sim_time` | `false` | Use the simulation clock. |
| `use_joy` | `true` | Start `joy_node` and the onboard joystick node. |
| `use_nav2` | `true` | Include `nav2.launch.py`. `false` for T1, which brings its own nav2 without AMCL (`launch_t1.launch.py` passes it). |
| `use_web` | `true` | Start the robot-hosted web GUI on port 8080. |
| `joystick_profile` | `auto` | Joystick profile stem, or `auto` to detect from the pad. |

The detector arguments (`yolo_imgsz`, `yolo_model`, `use_pose_detector`,
`use_fetch_detector`, `fetch_model`, `fetch_imgsz`) are **gone from here** and live on
`mecanumbot_sensorprocess_smart`'s `perception.launch.py`, which the behaviour launch
files include. The behaviour launchers forward them, so:

```bash
# perception on its own, no tree
ros2 launch mecanumbot_sensorprocess_smart perception.launch.py detector:=fetch

# or through the behaviour that wants it
ros2 launch mecanumbot_leading_behaviour launch_wifi_condition_sequence.launch.py \
    condition:=Doglike yolo_imgsz:=640
```

## Additional notes

- This package is a coordinator: node logic lives in packages such as `mecanumbot_core`, `mecanumbot_led`, and external dependencies.
- The perception pipeline deliberately does **not** live here, even though launch orchestration otherwise does: this package depends on `mecanumbot_web`, which depends on `mecanumbot_leading_behaviour`, so a behaviour package that depended on `mecanumbot_bringup` would close a dependency cycle. It lives in `mecanumbot_sensorprocess_smart`, which owns the nodes anyway.
- Launch argument defaults (namespace, sim time, map/params) are defined in the launch files listed above.
- SSID to map mapping, done by `nav2.launch.py` (and so by the base launch under `use_nav2`; the copy in `launch_external.launch.py` is commented out): `MecanumNet` -> `AI_dept`, `MecanumetoNet` -> `LED_exp` (with keepout mask). Anything else falls back to `AI_dept`. A map pinned on the web GUI's `/maps` page overrides this; see `mecanumbot_web/README.md`, "Maps".
