Fortuz/mecanumbot/mecanumbot/CHANGELOG.rst

^^^^^^^^^^^^^^^^^^^^^^^^^^^^^^^^
Changelog for package mecanumbot
^^^^^^^^^^^^^^^^^^^^^^^^^^^^^^^^

0.0.1 (2025-07-07)
------------------
* Seting up the package 
* Contributors: Balázs Nagy
