Fortuz/mecanumbot/mecanumbot_core/mecanumbot_core/mecanumbot_IO_node.py

import math
import os
import struct
import threading
import time

import rclpy
import serial
from geometry_msgs.msg import Twist
from mecanumbot_msgs.msg import AccessMotorCmd, OpenCRState
from rclpy.callback_groups import ReentrantCallbackGroup
from rclpy.executors import MultiThreadedExecutor
from rclpy.node import Node
from rclpy.qos import HistoryPolicy, QoSProfile, ReliabilityPolicy


# import wiringpi
############################################### HELPER FUNCTIONS ################################################
def crc8_ccitt(data: bytes) -> int:
    crc = 0x00
    for b in data:
        crc ^= b
        for _ in range(8):
            if crc & 0x80:
                crc = ((crc << 1) & 0xFF) ^ 0x07
            else:
                crc = (crc << 1) & 0xFF
    return crc & 0xFF


################################################ MAIN CLASS ################################################
class Mecanumbot_IO_Node(Node):

    def __init__(self, namespace=""):
        super().__init__("mecanumbot_io_node", namespace=namespace)
        self.callback_group = ReentrantCallbackGroup()
        self.cmd_lock = threading.RLock()
        # Guards the serial port against interleaved writes from the tx timer
        # and the shutdown path. Deliberately separate from cmd_lock so that a
        # slow write never blocks a command callback.
        self.tx_lock = threading.Lock()

        default_device = "COM3" if os.name == "nt" else "/dev/opencr"
        self.declare_parameters(
            namespace=namespace,
            parameters=[
                ("dev_params.device_name", default_device),
                ("dev_params.baudrate", 1000000),
                # Rate at which the current command set is pushed to the board.
                # The write is periodic rather than per-message so that an
                # incoming cmd_vel can never block on the serial link.
                ("dev_params.tx_hz", 50.0),
                # The wheels stop when no cmd_vel has arrived for this long, in
                # seconds; 0 disables it. Without it a publisher that dies
                # mid-turn leaves the robot turning on its last command.
                ("dev_params.cmd_vel_timeout", 0.5),
                # Robot parameters
                ("robot_params.wheel.radius", 0.0325),
                ("robot_params.wheel.separation_x", 0.129),
                ("robot_params.wheel.separation_y", 0.300),
                ("robot_params.wheel.vel_tick", 0.229),
                # Ceiling on a single wheel command, in board ticks. Also the
                # lever for peak current draw: four wheels accelerating to this
                # at once is the worst case the supply sees.
                ("robot_params.wheel.max_cmd_ticks", 300),
                ("robot_params.accessory.neck_default", 850),
                ("robot_params.accessory.grabber_default", 512),
                # Packet parameters
                ("packet_params.payload_fmt", "<27h15f"),
                ("packet_params.seq_size", 1),
                ("packet_params.crc_size", 1),
                ("packet_params.magic", "55AA"),  # list because YAML can't store bytes
                # Plausibility parameters
                ("plausibility_params.max_wheel_speed", 10000),
                ("plausibility_params.min_pos", -1000),
                ("plausibility_params.max_pos", 10000),
                ("plausibility_params.max_float_abs", 1e7),
            ],
        )

        # Retrieve parameters
        self.device_name = self.get_parameter("dev_params.device_name").value
        self.baudrate = self.get_parameter("dev_params.baudrate").value
        self.tx_hz = max(1.0, float(self.get_parameter("dev_params.tx_hz").value))
        self.cmd_vel_timeout = float(
            self.get_parameter("dev_params.cmd_vel_timeout").value
        )
        self.wheel_radius = self.get_parameter("robot_params.wheel.radius").value
        self.wheel_separation_x = self.get_parameter(
            "robot_params.wheel.separation_x"
        ).value
        self.wheel_separation_y = self.get_parameter(
            "robot_params.wheel.separation_y"
        ).value
        self.max_cmd_ticks = abs(
            int(self.get_parameter("robot_params.wheel.max_cmd_ticks").value)
        )

        self.payload_fmt = self.get_parameter("packet_params.payload_fmt").value
        self.seq_size = self.get_parameter("packet_params.seq_size").value
        self.crc_size = self.get_parameter("packet_params.crc_size").value
        self.magic = bytes.fromhex(self.get_parameter("packet_params.magic").value)

        self.payload_size = struct.calcsize(self.payload_fmt)
        self.full_packet_size = (
            len(self.magic) + self.seq_size + self.payload_size + self.crc_size
        )

        self.vel_tick = (
            self.get_parameter("robot_params.wheel.vel_tick").value / 60
        )  # rot/min to rot/s, in 1 int diff
        self.max_wheel_speed = self.get_parameter(
            "plausibility_params.max_wheel_speed"
        ).value
        self.min_pos = self.get_parameter("plausibility_params.min_pos").value
        self.max_pos = self.get_parameter("plausibility_params.max_pos").value
        self.max_float_abs = self.get_parameter(
            "plausibility_params.max_float_abs"
        ).value
        self.neck_default = self.get_parameter(
            "robot_params.accessory.neck_default"
        ).value
        # self.grabber_default = self.get_parameter('robot_params.accessory.grabber_default').value

        self.scale = (
            self.vel_tick * 2 * math.pi * self.wheel_radius
        )  # tick - unit diff of wheel velocoties in rpm, 2Rpi - distance/rotation, wheel_radius - m
        self.wheel_dist_scale = (self.wheel_separation_x + self.wheel_separation_y) / 2

        # Log parameters

        self.get_logger().info(
            f"Device: {self.device_name} @ {self.baudrate} baud, tx {self.tx_hz} Hz, "
            f"wheels stop after {self.cmd_vel_timeout} s without cmd_vel"
        )
        self.get_logger().info(
            f"Packet: payload_size={self.payload_size}, full_packet_size={self.full_packet_size}"
        )
        self.get_logger().info(
            f"Plausibility: max_speed={self.max_wheel_speed}, pos_range=[{self.min_pos},{self.max_pos}], max_float={self.max_float_abs}"
        )

        self.rx_lock = threading.Lock()
        self._stop_event = threading.Event()
        self.init_serial()
        self.init_reader_thread()

        self.vals = None
        self.opencr_publisher_ = self.create_publisher(OpenCRState, "opencr_state", 10)
        timer_period = 0.01  # seconds
        self.timer = self.create_timer(
            timer_period, self.timer_callback, callback_group=self.callback_group
        )
        self.opencr_state = OpenCRState()

        self.i = 0
        self.rx_buffer = bytearray()

        # Gates the tx timer until a real command has been seen; see
        # update_motor_cmds_out.
        self._have_command = False
        self._last_vel_time = None
        self.cmd_outputs = {
            "BL_vel": 0,
            "BR_vel": 0,
            "FL_vel": 0,
            "FR_vel": 0,
            "N_pos": 550,
            "GL_pos": 683,
            "GR_pos": 336,
        }
        # Depth 1: a velocity stream only ever wants its newest sample. A
        # deeper queue is a latency buffer -- a backlog here shows up as the
        # wheels obeying commands the operator gave a moment ago.
        self.vel_subscription = self.create_subscription(
            Twist,
            "cmd_vel",
            self.vel_cmd_callback,
            QoSProfile(
                depth=1,
                history=HistoryPolicy.KEEP_LAST,
                reliability=ReliabilityPolicy.RELIABLE,
            ),
            callback_group=self.callback_group,
        )
        self.pos_subscription = self.create_subscription(
            AccessMotorCmd,
            "cmd_accessory_pos",
            self.access_motor_cmd_callback,
            10,
            callback_group=self.callback_group,
        )

        # The command set is pushed to the board on its own timer. Writing
        # from the subscription callbacks instead made the achievable serial
        # rate a hard cap on the cmd_vel rate, so a faster publisher simply
        # built a backlog of stale commands.
        self.tx_timer = self.create_timer(
            1.0 / self.tx_hz,
            self.update_motor_cmds_out,
            callback_group=self.callback_group,
        )

        self.GPIO_pin = 27
        # wiringpi.pinMode(self.GPIO_pin,1)
        # wiringpi.digitalWrite(self.GPIO_pin,0)
        self.vel_subscription  # prevent unused variable warning
        self.pos_subscription  # prevent unused variable warning

    def init_serial(self):
        try:
            self.ser = serial.Serial(self.device_name, self.baudrate, timeout=0.1)
            self.get_logger().info("Serial port opened successfully.")
        except serial.SerialException as e:
            self.get_logger().error(f"Error opening serial port: {e}")
            self.ser = None

    def init_reader_thread(self):
        self.reader = threading.Thread(target=self.read_thread_fn, daemon=True)
        self.reader.start()

    def close_serial(self):
        self.get_logger().info("Initiating safe shutdown sequence...")

        # 1. Stop the tx timer so nothing races the final stop frame
        if getattr(self, "tx_timer", None) is not None:
            self.tx_timer.cancel()

        # 2. Stop the motors to prevent a runaway robot
        with self.cmd_lock:
            self.cmd_outputs["BL_vel"] = 0
            self.cmd_outputs["BR_vel"] = 0
            self.cmd_outputs["FL_vel"] = 0
            self.cmd_outputs["FR_vel"] = 0
        self.update_motor_cmds_out(force=True)

        # 3. Signal the reader thread to stop and wait for it
        self._stop_event.set()
        if getattr(self, "reader", None) is not None:
            self.reader.join(timeout=1.0)

        # 4. Safely close the serial port
        if self.ser is not None and self.ser.is_open:
            self.ser.close()

        self.get_logger().info("Serial port closed safely.")

    # Plausibility check for received payload
    # Returns True if the payload is plausible, False otherwise
    # A payload is plausible if it fits within certain ranges for wheel speeds, positions, and float values
    def plausible_payload(self, vals):
        shorts = vals[:27]
        floats = vals[27:42]
        # wheel velocities check
        for v in shorts[:4]:
            if abs(v) > self.max_wheel_speed:
                self.get_logger().warn("Wheel speed too high")
                return False
        # positions check
        for p in shorts[20:23]:
            if p < self.min_pos or p > self.max_pos:
                self.get_logger().warn("Minimum or maximum position wrong.")
                return False
        # floats check
        for f in floats:
            if math.isnan(f) or math.isinf(f) or abs(f) > self.max_float_abs:
                self.get_logger().warn("Payload has float error")
                return False
        return True

    def update_opencr_state_in(self):
        with self.rx_lock:
            if self.vals is None:
                self.get_logger().warn("No valid data received yet.")
                return
            vals = self.vals
        shorts = vals[:27]
        floats = vals[27:42]
        self.opencr_state.header.stamp = self.get_clock().now().to_msg()
        self.opencr_state.cmd_vel_bl = shorts[0]
        self.opencr_state.cmd_vel_br = shorts[1]
        self.opencr_state.cmd_vel_fl = shorts[2]
        self.opencr_state.cmd_vel_fr = shorts[3]
        self.opencr_state.vel_bl = shorts[4]
        self.opencr_state.vel_br = shorts[5]
        self.opencr_state.vel_fl = shorts[6]
        self.opencr_state.vel_fr = shorts[7]
        self.opencr_state.pos_bl = shorts[8]
        self.opencr_state.pos_br = shorts[9]
        self.opencr_state.pos_fl = shorts[10]
        self.opencr_state.pos_fr = shorts[11]
        self.opencr_state.curr_bl = shorts[12]
        self.opencr_state.curr_br = shorts[13]
        self.opencr_state.curr_fl = shorts[14]
        self.opencr_state.curr_fr = shorts[15]
        self.opencr_state.acc_bl = shorts[16]
        self.opencr_state.acc_br = shorts[17]
        self.opencr_state.acc_fl = shorts[18]
        self.opencr_state.acc_fr = shorts[19]
        self.opencr_state.pos_n = shorts[20]
        self.opencr_state.pos_gl = shorts[21]
        self.opencr_state.pos_gr = shorts[22]
        self.opencr_state.err_bl = shorts[23]
        self.opencr_state.err_br = shorts[24]
        self.opencr_state.err_fl = shorts[25]
        self.opencr_state.err_fr = shorts[26]
        # A negative err_* is the board's "this wheel did not answer" sentinel,
        # not a Dynamixel hardware error code. Everything else it reports about
        # the wheels is then the last good sample, so say so: a silent Dynamixel
        # bus otherwise looks exactly like a robot ignoring its own feedback,
        # because cmd_vel_* is the command echoed back rather than a read.
        if min(shorts[23:27]) < 0:
            self.get_logger().warn(
                "OpenCR cannot read the Dynamixel bus: wheel velocity, position, "
                "current and error state are stale. Check DXL power and cabling.",
                throttle_duration_sec=5.0,
            )
        elif any(e & 1 for e in shorts[23:27]):
            # Bit 0 of the XM430 Hardware Error Status. Reported, not acted on:
            # the motors keep driving with it set, the flag latches until they
            # are power-cycled, and stopping a trial on a latched flag would
            # cost more than it saves.
            self.get_logger().warn(
                "Wheels report Input Voltage Error: the motor supply is out of "
                "range. Latches until the motors are power-cycled.",
                throttle_duration_sec=10.0,
            )
        self.opencr_state.dms = floats[0]
        self.opencr_state.battery_voltage = floats[1]
        self.opencr_state.imu_angular_vel_x = floats[2]
        self.opencr_state.imu_angular_vel_y = floats[3]
        self.opencr_state.imu_angular_vel_z = floats[4]
        self.opencr_state.imu_linear_acc_x = floats[5]
        self.opencr_state.imu_linear_acc_y = floats[6]
        self.opencr_state.imu_linear_acc_z = floats[7]
        self.opencr_state.imu_magnetic_x = floats[8]
        self.opencr_state.imu_magnetic_y = floats[9]
        self.opencr_state.imu_magnetic_z = floats[10]
        self.opencr_state.imu_orientation_w = floats[11]
        self.opencr_state.imu_orientation_x = floats[12]
        self.opencr_state.imu_orientation_y = floats[13]
        self.opencr_state.imu_orientation_z = floats[14]

    def vel_cmd_callback(self, msg):
        # wiringpi.digitalWrite(self.GPIO_pin,1)
        # Standard mecanum kinematics
        Vx = msg.linear.x
        Vy = msg.linear.y
        Wz = msg.angular.z

        # Calculate raw velocities
        bl_raw = (Vx + Vy - (Wz * self.wheel_dist_scale)) / self.scale
        br_raw = (Vx - Vy + (Wz * self.wheel_dist_scale)) / self.scale
        fl_raw = (Vx - Vy - (Wz * self.wheel_dist_scale)) / self.scale
        fr_raw = (Vx + Vy + (Wz * self.wheel_dist_scale)) / self.scale

        # Only update the command set; the tx timer owns the serial write.
        with self.cmd_lock:
            limit = self.max_cmd_ticks
            self.cmd_outputs["BL_vel"] = max(min(bl_raw, limit), -limit)
            self.cmd_outputs["FL_vel"] = max(min(fl_raw, limit), -limit)
            self.cmd_outputs["BR_vel"] = max(min(br_raw, limit), -limit)
            self.cmd_outputs["FR_vel"] = max(min(fr_raw, limit), -limit)
            self._have_command = True
            self._last_vel_time = time.monotonic()

    def access_motor_cmd_callback(self, msg):
        # wiringpi.digitalWrite(self.GPIO_pin,1)
        with self.cmd_lock:
            self.cmd_outputs["N_pos"] = msg.n_pos * 100
            self.cmd_outputs["GL_pos"] = msg.gl_pos * 100
            self.cmd_outputs["GR_pos"] = msg.gr_pos * 100
            self._have_command = True

    def wheel_feedback_lost(self):
        """
        Report whether the board says it cannot read the wheels.

        A negative ``err_*`` is the board's DXL_UNREADABLE sentinel, which means
        every other wheel field in the packet is a stale sample rather than a
        reading.
        """
        with self.rx_lock:
            vals = self.vals
        if vals is None:
            return False
        return min(vals[23:27]) < 0

    def cmd_vel_timed_out(self):
        """Report whether the last velocity command is too old to keep obeying."""
        if self.cmd_vel_timeout <= 0.0 or self._last_vel_time is None:
            return False
        return time.monotonic() - self._last_vel_time > self.cmd_vel_timeout

    def update_motor_cmds_out(self, force=False):
        """
        Push the current command set to the board.

        Driven by the tx timer, never by a subscription callback: the whole
        7-short frame is absolute state, so sending the latest snapshot at a
        fixed rate carries exactly the same information as sending one frame
        per message, without coupling the serial rate to the message rate.

        Stays silent until the first command arrives so that starting the
        node does not by itself drive the accessories to their defaults;
        ``force`` overrides that for the stop frame on shutdown.
        """
        if not (self._have_command or force):
            return

        # Driving the wheels while the board cannot hear them is driving blind:
        # the feedback that would show it going wrong is exactly what is
        # missing, and on this robot a silent bus has meant a sagging supply.
        # Hold them at zero until reads come back -- it recovers on its own, no
        # latch. Only the wheels: zeroing a position command would slam the neck
        # to 0, and the shutdown stop frame (force) must always go out.
        hold_wheels = not force and self.wheel_feedback_lost()
        if hold_wheels:
            self.get_logger().warn(
                "Holding the wheels at zero: OpenCR cannot read the Dynamixel bus.",
                throttle_duration_sec=5.0,
            )

        fmt = "<7h"
        with self.cmd_lock:
            if self.cmd_vel_timed_out():
                for wheel in ("BL_vel", "BR_vel", "FL_vel", "FR_vel"):
                    self.cmd_outputs[wheel] = 0
                self._last_vel_time = None
                self.get_logger().warn(
                    f"No cmd_vel for {self.cmd_vel_timeout} s: stopping the wheels."
                )
            wheels = (
                (0, 0, 0, 0)
                if hold_wheels
                else (
                    int(self.cmd_outputs["BL_vel"]),
                    int(self.cmd_outputs["BR_vel"]),
                    int(self.cmd_outputs["FL_vel"]),
                    int(self.cmd_outputs["FR_vel"]),
                )
            )
            try:
                message_bytes = struct.pack(
                    fmt,
                    *wheels,
                    int(self.cmd_outputs["N_pos"]),
                    int(self.cmd_outputs["GL_pos"]),
                    int(self.cmd_outputs["GR_pos"]),
                )
            except struct.error as e:
                # Out of range for <7h. Skip this frame rather than let the
                # exception kill the timer and freeze the command stream.
                self.get_logger().error(
                    f"Command does not fit the packet, skipping: {e}",
                    throttle_duration_sec=1.0,
                )
                return

        if self.ser is None or not self.ser.is_open:
            return

        # Written outside cmd_lock so the link can never stall a callback.
        with self.tx_lock:
            try:
                self.ser.write(message_bytes)
                self.ser.flush()
                # wiringpi.digitalWrite(self.GPIO_pin,0)
            except serial.SerialException as e:
                self.get_logger().error(f"Serial write failed: {e}")

    def timer_callback(self):
        # self.get_logger().info("Timer callback triggered")
        self.update_opencr_state_in()
        self.opencr_publisher_.publish(self.opencr_state)
        # self.get_logger().info("OpencR State Published")
        # self.get_logger().info('Publishing: "%s"' % self.opencr_state)
        # self.update_motor_cmds_out()
        self.i += 1

    def read_thread_fn(self):
        """Continuously read serial data, extract packets, and update self.vals safely."""
        if self.ser is None:
            self.get_logger().error("Serial not initialized; reader thread exiting.")
            return

        while rclpy.ok() and not self._stop_event.is_set():
            try:
                chunk = self.ser.read(self.ser.in_waiting or 1)
                if chunk:
                    self.rx_buffer.extend(chunk)

                # Keep buffer bounded
                if len(self.rx_buffer) > 4096:
                    self.rx_buffer = self.rx_buffer[-2048:]

                # Try to find magic header
                idx = self.rx_buffer.find(self.magic)
                if idx == -1:
                    time.sleep(0.001)
                    continue

                # Not enough bytes for full packet -> wait
                if len(self.rx_buffer) - idx < self.full_packet_size:
                    time.sleep(0.001)
                    continue

                # Extract packet
                start = idx
                end = start + self.full_packet_size
                packet = bytes(self.rx_buffer[start:end])

                seq = packet[len(self.magic)]
                payload_bytes = packet[
                    len(self.magic)
                    + self.seq_size : len(self.magic)
                    + self.seq_size
                    + self.payload_size
                ]
                recv_crc = packet[-1]

                # Compute CRC
                computed_crc = crc8_ccitt(packet[:-1])

                # Bad CRC → discard only magic byte and keep scanning
                if computed_crc != recv_crc:
                    del self.rx_buffer[start : start + 1]
                    self.get_logger().warning(
                        f"Packet CRC mismatch, computed: {computed_crc}, "
                        f"received: {recv_crc}",
                        throttle_duration_sec=1.0,
                    )
                    continue

                # Unpack packet
                vals = struct.unpack(self.payload_fmt, payload_bytes)

                # Check plausibility
                if not self.plausible_payload(vals):
                    del self.rx_buffer[start : start + 1]
                    continue

                with self.rx_lock:
                    self.vals = vals

                del self.rx_buffer[:end]

            except serial.SerialException as e:
                self.get_logger().error(f"Serial error in read thread: {e}")
                time.sleep(0.5)

            except Exception as e:
                self.get_logger().error(f"Unexpected error in read thread: {e}")
                time.sleep(0.05)


def main(args=None):
    rclpy.init(args=args)
    # wiringpi.wiringPiSetupGpio()
    io_node = Mecanumbot_IO_Node()

    executor = MultiThreadedExecutor()
    executor.add_node(io_node)

    try:
        executor.spin()
    except KeyboardInterrupt:
        pass
    finally:
        io_node.close_serial()
        io_node.destroy_node()
        rclpy.shutdown()


if __name__ == "__main__":
    main()
