Fortuz/mecanumbot/(commit log)

2025-08-18 decription package, no collision and inertia
    [arm.STL, arm_left.STL, arm_right.STL, common_properties.urdf, head.STL, lds.stl, mecanumbot.urdf, turtlebot3_waffle_pi.urdf]
2025-08-21 3D printable parts added
    [cam_bridge.stl, diffuser.stl, grabbermount_front.stl, grabbermount_rear.stl, omniwheel_adapter.stl]
2025-08-21 Readme update - LED control
2025-08-22 joint state modified
2025-08-25 urdf collision added
    [mecanumbot_norm.urdf]
2025-08-25 mecanumbot_description builds
    [mecanumbot.urdf, mecanumbot_test.urdf]
2025-08-25 clean up
    [mecanumbot_test.urdf, turtlebot3_waffle_pi.urdf]
2025-08-25 refactor ledgui
2025-08-25 ledgui python works (pkg not)
2025-08-25 bug fic teleop
    [mecanumbot.urdf]
2025-08-25 joinz ug fix
    [mecanumbot.urdf]
2025-08-25 joint name fix
2025-08-25 no namespace in description
    [mecanumbot.urdf]
2025-08-25 velocity and last diff array 4 element fix
2025-08-27 A GUI-hoz minden funkció elkészült:szin,mód,mentés,firestorm
    [arm.STL, arm_left.STL, arm_right.STL, cam_bridge.stl, common_properties.urdf, diffuser.stl, grabbermount_front.stl, grabbermount_rear.stl]
2025-08-27 Ignore future changes to led_configs.json
2025-08-29 urdf with relative path
    [mecanumbot.urdf]
2025-08-29 urdf namespace added and path
    [mecanumbot.urdf]
2025-08-29 deleted colcon trash
    [arm.STL, arm_left.STL, arm_right.STL, cam_bridge.stl, common_properties.urdf, diffuser.stl, grabbermount_front.stl, grabbermount_rear.stl]
2025-09-01 parameters set, urdf fixed
    [arm.STL, arm.stl, arm_left.STL, arm_left.stl, arm_right.STL, arm_right.stl, base.stl, head.STL]
2025-09-02 is connected device check with log
2025-09-02 print out
2025-09-02 is connected device hard true test
2025-09-09 Accessory motor control in teleop
    Add motor controls to macanumbot_teleop
    TODO: fine-tune parameters
2025-09-09 Solve communication with accessory motors
    add and declare new functions that handle the memory control
    modify control table to include new addresses
2025-09-18 Replace diff drive with mecanum drive in the odometry - Commit by Csenge
    Create first version of odometry, replace some variables
2025-09-19 minor bugfix in dy and dx calculations in odom - Csenge replace duplicate wheel_rls with rr-s
2025-09-19 fix theta - Csenge Try for a new delta theta calculation method in odometry.cpp If this fixes the issue why did the turtlebot's original code work?
2025-09-22 odometry bugfix try - I
    reintroduce the calculation of theta based on turtlebt3's
    turtlebot_node
2025-09-22 Add debug lines
    Add debug lines to odometry.cpp
2025-09-22 integrate mecanum drive to odom - finish
    add wheel-based calculation to yamls
    debug odometry code
2025-09-25 last correct state - Csenge
    fix bugs in odometry(angular vs linear vel mixup)
    TODO - check inducedopencr error
2025-09-26 stabilise opencr communication - Csenge
    lower baudrate between board and pi
    remove debug messages
2025-09-30 navigation bugfix - nav2 starts the robot motors - Csenge add missing nodes needed to run navigation (control, behavior servers, bt_navigator) fine-tune some parameters in nav2_params.yaml TODO: bugf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
2025-10-03 debug odometry
    add check of joint_indices
    add time warning
    add position overflow warning
2025-10-03 reindex wheels
2025-10-03 fix wheel order
2025-10-06 odometry fix attempt - inf, Csenge change angle based on which dx and dy are calculated add debug level logging to launch
2025-10-06 add info about wheel order
2025-10-06 debugged wheel orders
2025-10-06 wheel order should be correct now -Csenge
2025-10-06 final (?) wheel order
2025-10-06 init velocity-based odometry calculations - Csenge replace wheel position with velocities for calculation TODO: fine-tune parameters
2025-10-06 fix differential velocity - create normal one - Csenge
2025-10-06 debug wheel order
2025-10-06 reordered wheels
2025-10-07 Arrange joints for odometry
    Change joint state orders to represent dynamixel ID orders
    Introduce the change to odometry - now it works as desired
2025-10-07 Fix typos in joint_state.cpp
    place missplaced commas
2025-10-07 Add final(?) fix to angular component - Csenge
    Divide theta value by 2 in odometry.cpp
2025-10-09 update control table, info to debug - Csenge
    update wheel orders in control table
    apply new IDs in turtlebot.cpp
    place odometry output from info to debug
2025-10-09 update read_memo length - Csenge
    set memory_length using the last address instead of last wheel address
2025-10-09 add debug lines to read_register
    determine the case gotten for fault
2025-10-09 deduce communication error type
    add error print
2025-10-13 add debug velocity info
2025-10-13 Add back velocities
2025-10-13 fix odometry
2025-10-13 updated joint state maybe works
2025-10-16 Update camera launch
    Add new camera config optimised for pi cameras
    Make the camera.launch.py use the v4l2 camera handling
2025-10-31 Introduce new debug lines
    -Check if TxRx r/w happens
    -Insert error messages for write fails
2025-10-31 Skip a rw cycle
    Add error handling to dynamixel_sdk_wrapper.cpp and .hpp -
    make the set_data and read_register skip a read/write step in case of previous error
2025-11-06 Robustness fix attempts (time,stack,comments) - Csenge
    - Make read register statuses debug messages from info in dynamixel_sdk_wrapper.cpp
    - Increase waits in case of comm error in dynamixel_sdk_wrapper.cpp
    - reduce read_data_size dynamixel_sdk_wrapper.hpp
2025-11-06 Reformat cmd_vel_callback - Csenge
    Send out command velocities in two batch -linear and angular
    Get rid of redundant bytes(lin z and ang xy)
2025-11-10 Replace command calbacks in turtlebot3 node
    Create wheel velocities from cmd_vel - send those back
    Merge position commands to get 1 callback
    Create message type that handles all 3 position commands
2025-11-13 Create new message types for handling opencr memory and position commands - Csenge
    create accessmotorcmd to store all accessory motor commands as 1
    create opencrstate to make opencr input message processing run through a single topic
2025-11-14 Introducing new core node - Csenge
    create IO node that handles communication with opencr
    modify slight mistake in OpenCRState message
    [mecanumbot_IO_node.py]
2025-11-14 Add sensorprocessing node - Csenge
    Create node to core that handles sensors from OpenCR board (IMU, ODOM, BATTSTATE,JOINTSTATE)
    Modify OpenCR sensorstate params to be more clear
2025-11-14 Modify velocity handling
    Make handling velocities prettier in the odometry calculations
    Write the exact command values to wheel velocitiess in the IO node
    create common parameters for the 2 nodes
2025-11-14 fix time handling syntax in sensorprocessing
    [mecanumbot_sensorproc_node.py]
2025-11-14 Add namespace to nodes and LiDAR and state publish
    core nodes can now launch with namespace
    add LiDAR and state publisher to launch file
2025-11-17 fix name error in sensorproc - Csenge
    [mecanumbot_sensorproc_node.py]
2025-11-17 fix syntax error in sensorproc - Csenge
    [mecanumbot_IO_node.py, mecanumbot_sensorproc_node.py]
2025-11-17 fix syntax error in IO - Csenge
    [mecanumbot_IO_node.py]
2025-11-17 change wheel-velocity direction calculations in IO and sensorproc nodes
2025-11-17 fix odom syntax error in sensorproc_node - Csenge
    [mecanumbot_sensorproc_node.py]
2025-11-17 turn off imu from odom source - Csenge
2025-11-17 fix wheel commands
2025-11-17 add debug to sensorproc
2025-11-17 Define robot parameters for default positions - Csenge
    Implement measure against motor state error in IO node
    [mecanumbot_IO_node.py, mecanumbot_core_parameters.yaml]
2025-11-17 remove extra multriplier factor (average-related,wrong) - Csenge
    [mecanumbot_IO_node.py]
2025-11-17 Fix namespace issues
    Remove wrong namespace declaration and add missing ones in URDF
    Fix namespace declaration in state_publisher's launch
    [mecanumbot.urdf]
2025-11-17 remap joint_states
2025-11-17 remap joint_states syntax fix
2025-11-17 Add missing odom frame
    Create transform_broadcaster for odom frame and base_footprint frame
    [mecanumbot_sensorproc_node.py]
2025-11-18 Make link namespace pretty - Csenge
    add / to namespaces so that it does not get melted into the names
    [mecanumbot.urdf]
2025-11-18 check namespace and frames in use
2025-11-18 new namespace to LiDAR
2025-11-18 fix odometry orientation attempt
    [mecanumbot_sensorproc_node.py]
2025-11-18 Add updated .rviz file
    Update rviz file so that it contains all relevant sensor data correctly
    modify namespace print, now it should work
    [mecanumbot_sensorproc_node.py]
2025-11-19 Insert udev rules to mecanumbot_description
    Place udev rules from mecanumbot_bringup to mecanumbot_description
2025-11-19 Insert maps to mecanumbot description
    Move maps to description folder
2025-11-20 Stability fix attempts
    Increase IO node's publish rate
    Make buffer class variable
    [mecanumbot_IO_node.py]
2025-11-21 Fixes in IO node
    Make time handling more efficiennt and shorter
    Fix calculation of quaternions with saving last yaw angle
    Reduce timer period - send out more messages
    [mecanumbot_sensorproc_node.py]
2025-11-21 Reintroduce own thread for read processes in IO node
    Add self.reader thread to handle read_thread_fn
2025-11-21 handling of initialisation crash - if update is called before read
    [mecanumbot_IO_node.py]
2025-11-21 fix syntax in IO
    [mecanumbot_IO_node.py]
2025-11-21 Make IO node safer and more robust - attempt I
    Add mutex lock to make thread safer
    Refrain from using self.vals - it may be written during operations
2025-11-21 Odometry fix
    Replace wrongful calculations of current positions
    [mecanumbot_sensorproc_node.py]
2025-11-21 Changed parameter set for nav2
    Naav2 works with a different set of parameters
    TODO - wheel velocities get stuck
2025-11-24 Add modulo 2pi to odom's yaw
    Add modulo 2pi to correct the angle of direction (e.g. cos 420deg != cos 60 deg)
    [mecanumbot_sensorproc_node.py]
2025-11-24 mecanumbot_odom print remove
2025-11-24 check IMU based odometry
2025-11-24 odometry yaw update from IMU when needed
2025-11-28 introducjng LiDAR-based people detection
2025-12-01 Place sensorprocess node to the remote repository
    Delete mecanumbot_sensorprocess_smart
    Update Rviz with markers
2025-12-05 deactivate IMU from odom - test
2025-12-11 Fix default neck raise
    change default param from 330 to 850
    [mecanumbot_IO_node.py, mecanumbot_core_parameters.yaml]
2025-12-11 Add motor vel control limits
2026-01-16 increase LED communication baud
2026-01-16 rewrite string-based led query
2026-01-20 Fix joint state publisher
    Add missing namespace
    Add head and grabber joints
    [mecanumbot_sensorproc_node.py]
2026-01-20 position coordinate fix attempt
    [mecanumbot_sensorproc_node.py]
2026-01-29 Revert "Correct magic byte"
    This reverts commit f0bd86fbf65fb724ec4652b116e2c65dff2f27ed.
    [mecanumbot_IO_node.py]
2026-01-30 Add multi-threaded ROS node execution to IO handler node
2026-01-30 bugfix - insert missing comma
    [mecanumbot_IO_node.py]
2026-01-30 Add multi-threading to sensorproc node
2026-01-30 error status to control data flow
    [mecanumbot_IO_node.py]
2026-02-02 Multi-threading to LED node execution
2026-02-11 reduce number of motor commands
2026-02-11 add prints
2026-02-11 Revert "more detailed warning msg"
    This reverts commit 4e7a7360af3306bf6c3417a8d6186f50c5a82b72.
    [mecanumbot_IO_node.py]
2026-02-11 Revert "add prints"
    This reverts commit 9b7831da5058a4ec292406adf89f7669d6ad4274.
    [mecanumbot_IO_node.py]
2026-02-11 Revert "reduce number of motor commands"
    This reverts commit d2e4a66723ccd96ef9e0c8c91205c8b7f7f66989.
    [mecanumbot_IO_node.py]
2026-02-18 set correct gpio pin number
    [mecanumbot_IO_node.py]
2026-03-20 fix param file read
    [mecanumbot_core_parameters.yaml]
2026-03-20 led readme fix
2026-04-01 new manual camera node
2026-04-07 turn off wiringpi GPIO signals
2026-04-09 updated gripper posis
2026-04-09 new battery management added
2026-04-09 updatedlowest voltage
2026-04-09 add battery alerting
2026-04-10 added led to launch
2026-04-10 fix battery
2026-04-13 redo sensorproc
2026-04-13 add camera package
2026-04-21 set all camera backends to expect
2026-04-21 add device dependency to battery monitoring
2026-04-22 redo the arduino choice
2026-04-22 fix attempt for get ed status
    [led_control_node.py]
2026-04-23 battery alert modified
2026-04-30 board udev
2026-04-30 reset source of opencr
    [mecanumbot_IO_node.py]
2026-04-30 set camera open as raspi5
2026-04-30 minimal camera publisher for raspi5
2026-05-05 sensorproc cpu optim
2026-05-14 add device selection to compressed cam
2026-05-14 updated camera settings
2026-05-14 sim integration
    [mecanumbot.xml]
2026-05-15 sensorproc node handles batteries
2026-05-19 handle robot on wall power
2026-05-20 add camera to base launch and create audio input
2026-06-09 remove camera processing from startup
2026-06-11 add lidar detect to base bringup
2026-06-11 add lidar detect
2026-06-12 add lidar peopledetect to bringup
2026-06-15 add lidar check to monitor
2026-06-17 restore correct lidar detect
2026-06-23 add sensorfusion module
2026-06-23 fix pos_n weird error for now
    [mecanumbot_IO_node.py]
2026-06-23 fix weird neck error
    [mecanumbot_IO_node.py]
2026-06-29 neck pos feedback fixed?
    [mecanumbot_IO_node.py]
2026-06-29 add back missing read
    [mecanumbot_IO_node.py]
2026-07-16 compensate turnt motor
2026-07-16 fix mecanumbot neck tf
    [mecanumbot_sensorproc_node.py]
2026-07-16 introduce flp of motor to urdf
    [mecanumbot.urdf]
2026-07-17 fix midpoint of tf
    [mecanumbot_sensorproc_node.py]
2026-07-27 fix frames
2026-08-03 add sim and extra mapping settings
    [mecanumbot.xml, mecanumbot_arena.sdf, model.sdf]
2026-08-12 joy overwrite fix attempt
    [mecanumbot_battery_alert.py]
2026-09-01 more complex simulations for fear environment
    [mecanumbot.xml, model.sdf]
2026-09-03 move mecanumbot_sim
    [mecanumbot.xml, mecanumbot_arena.sdf, model.sdf]
2026-09-14 fix bug
    [mecanumbot.urdf]
2026-09-15 update camera discrepances
2026-09-15 Give slam_toolbox the lidar scan on a fixed angular grid
    The LD08 publishes every revolution with its own angle_min, angle_max and
    angle_increment and 201-206 readings. slam_toolbox builds its laser model
    from the first scan and drops every later scan with a different count, so
    depending on which scan came first a mapping run kept half its scans or
    almost none: on the robot the map stayed 0 x 0 for minutes and nav2's global
    costmap fell back to a 5 x 5 m square, "Robot is out of bounds of the
    costmap!".
    mecanumbot_scan_grid_node (mecanumbot_core) republishes each revolution on
    200 fixed 1.8 degree sectors, nearest valid return per sector, as
    /mecanumbot/scan_grid. slam_toolbox's mapping par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
    [mecanumbot_scan_grid_node.py, scan_grid.py]
2026-09-15 re-calibrate camera
2026-09-18 update urdf
    [mecanumbot.urdf]
2026-10-04 new led mode controls
2026-10-19 update cable info
2026-10-19 fix led situation
2026-10-19 led power source settled
